Makerspace-Amiens-2025-26/MachineThatDraws-Groupe07/docs/images/pcb-components.jpg

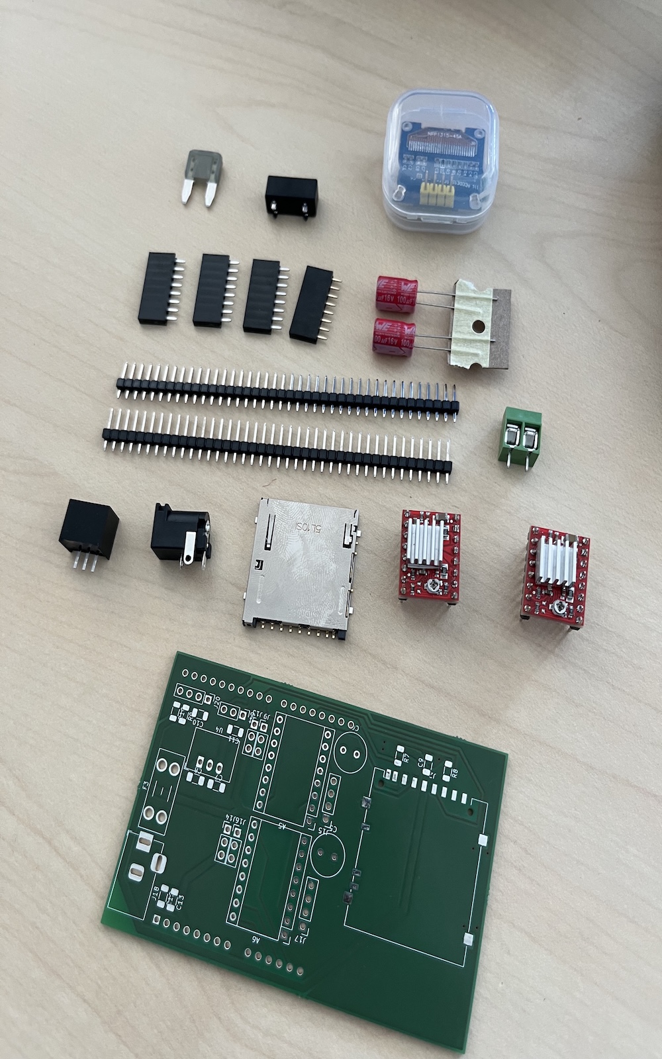
docs/images/pcb-components.jpg
