Makerspace-Amiens-2025-26/MachineThatDraws-Groupe07/docs/images/pcb-soldering.jpeg

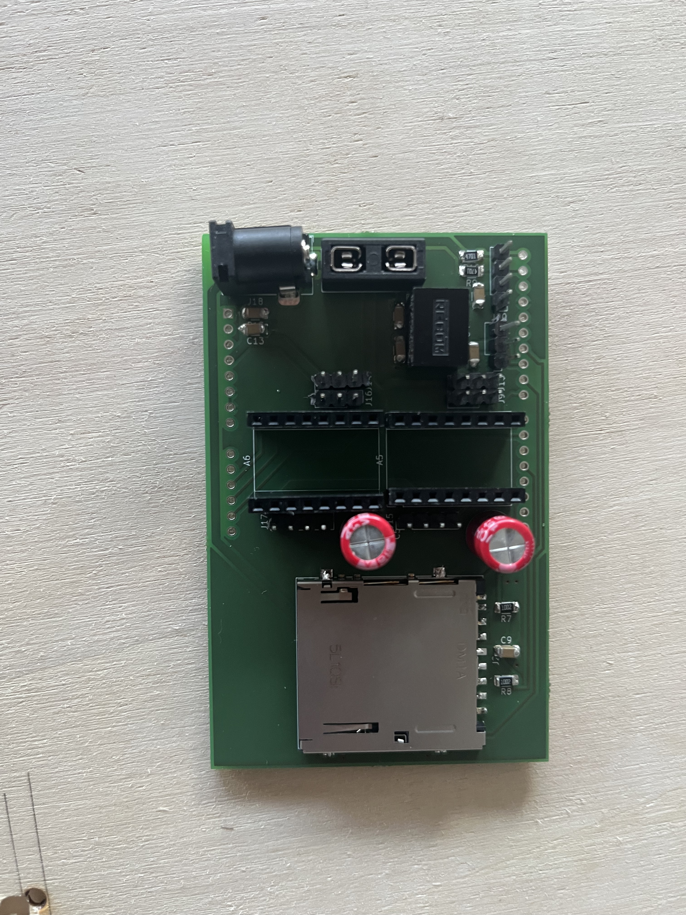
docs/images/pcb-soldering.jpeg
