Makerspace-Amiens-2025-26/MachineThatDraws-Groupe07/docs/index.md

Site
---
layout: home
nav_order: 1
title: Accueil
permalink: /
---

# Bienvenue sur notre documentation

Bienvenue dans la documentation de notre machine à dessiner nommée **"DrawBot A4"**.

Ce site a pour objectif de présenter notre projet, d’expliquer son fonctionnement et de fournir les informations nécessaires pour comprendre, utiliser et reproduire la machine.

Vous trouverez ci-dessous les principales ressources liées au projet, notamment les modèles 3D et le code source.

[Notre projet sur Onshape](https://cad.onshape.com/documents/e069393fab7baea4fdb59362/w/8d933c0b93562b63a8485ec1/e/e6b6ce24fbb03acfda1a5889){: .btn .btn-primary .fs-5 .mb-4 .mb-md-0 .mr-2 }
[Notre dépôt GitHub](https://github.com/Makerspace-Amiens/2026-MachineThatDraws-Groupe07/){: .btn .fs-5 .mb-4 .mb-md-0 }

{: .note }
> Le modèle 3D et la vidéo de présentation seront mis à jour au fur et à mesure de l’avancement du projet.

<iframe
height="600"
width="100%"
src="https://modelembedder.net/embed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"
frameborder="0">
</iframe>

## À propos du projet

Le **DrawBot A4** est une machine à dessiner utilisant un bras articulé.  
Ce projet nous permet d’apprendre et d’expérimenter la conception et la réalisation d’une machine répondant à un besoin concret : dessiner sur une feuille **A4**.

La machine peut également fonctionner comme un **traceur 2D**, capable de reproduire des images ou du texte de manière relativement précise.

## Poster du projet

Poster du projet DrawBot A4

## Vidéo de présentation

<video controls width="100%">
<source src="images/video_drawbot_a4.mp4" type="video/mp4">
</video>
