Makerspace-Amiens-2025-26/MachineThatDraws-Groupe07/docs/images/atelier.jpg

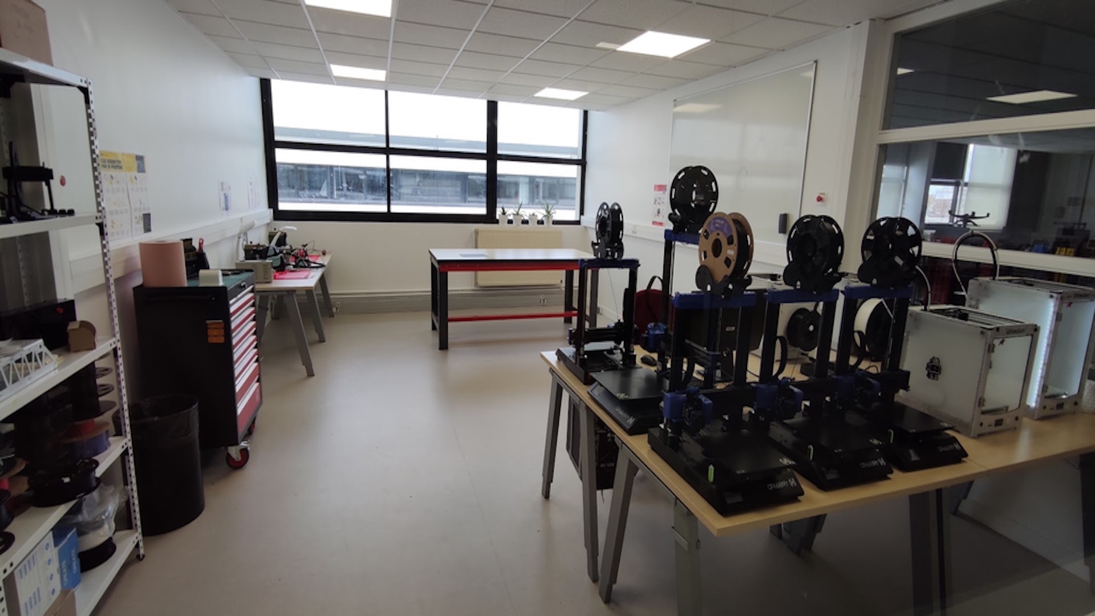
docs/images/atelier.jpg
