Makerspace-Amiens-2025-26/MachineThatDraws-Groupe07/docs/images/courroie.png

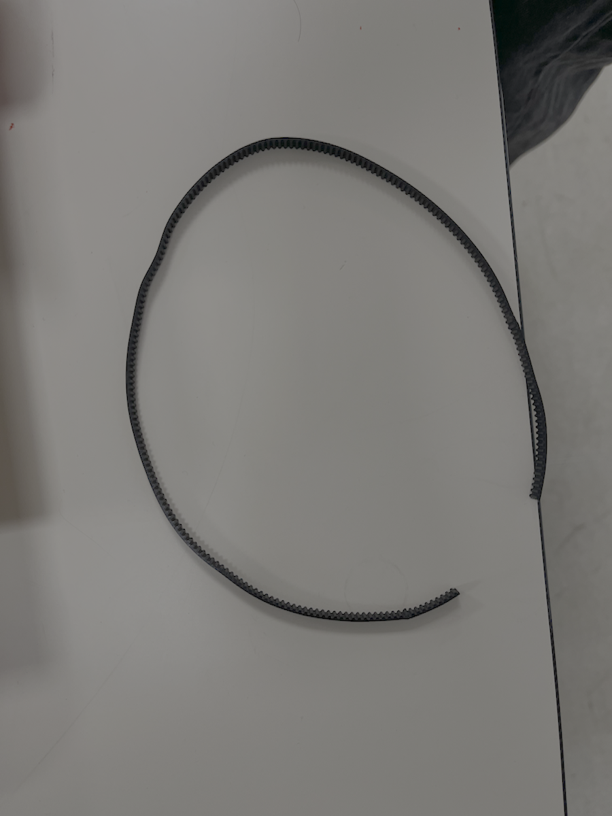
docs/images/courroie.png
