Makerspace-Amiens-2025-26/MachineThatDraws-Groupe07/docs/images/damien.jpg

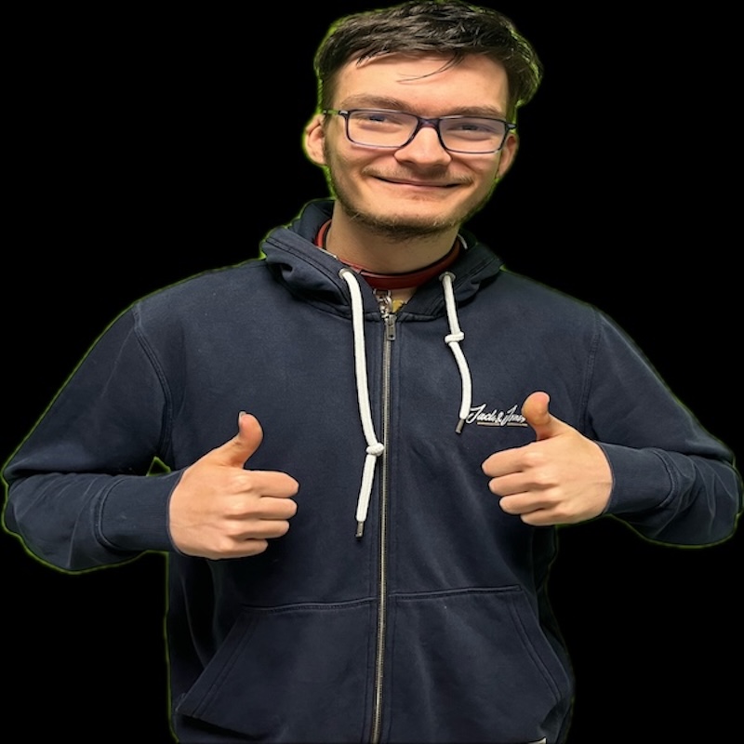
docs/images/damien.jpg
