Makerspace-Amiens-2025-26/MachineThatDraws-Groupe07/docs/images/feuille-support.png

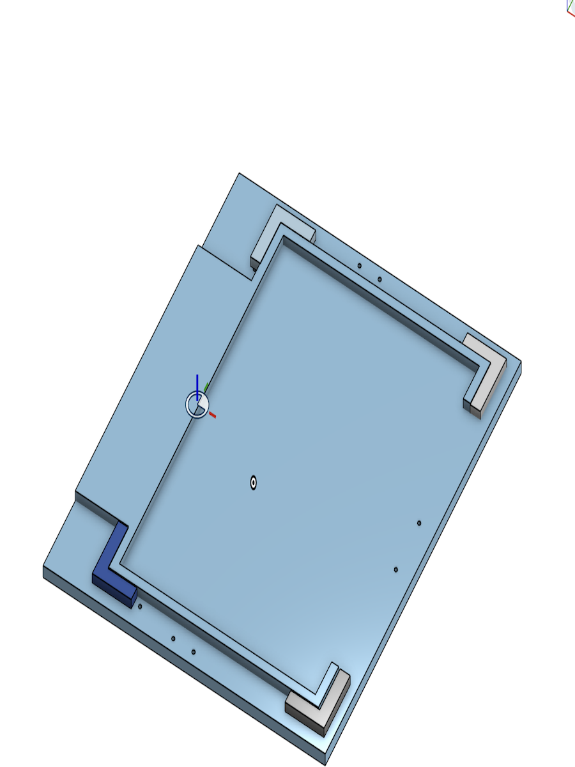
docs/images/feuille-support.png
