Makerspace-Amiens-2025-26/MachineThatDraws-Groupe07/docs/images/hero-drawbot.jpg

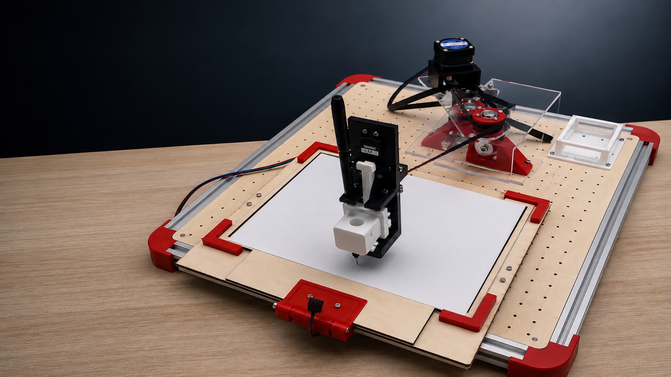
docs/images/hero-drawbot.jpg
