Makerspace-Amiens-2025-26/MachineThatDraws-Groupe07/docs/images/machine.png

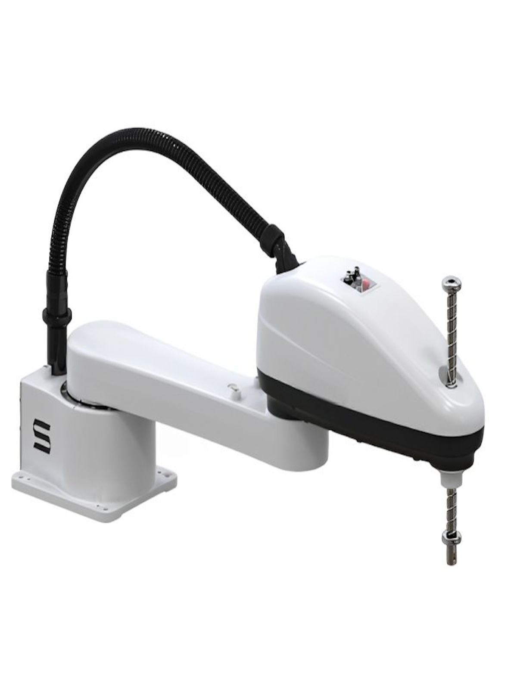
docs/images/machine.png
