Makerspace-Amiens-2025-26/MachineThatDraws-Groupe07/docs/images/maxence.jpg

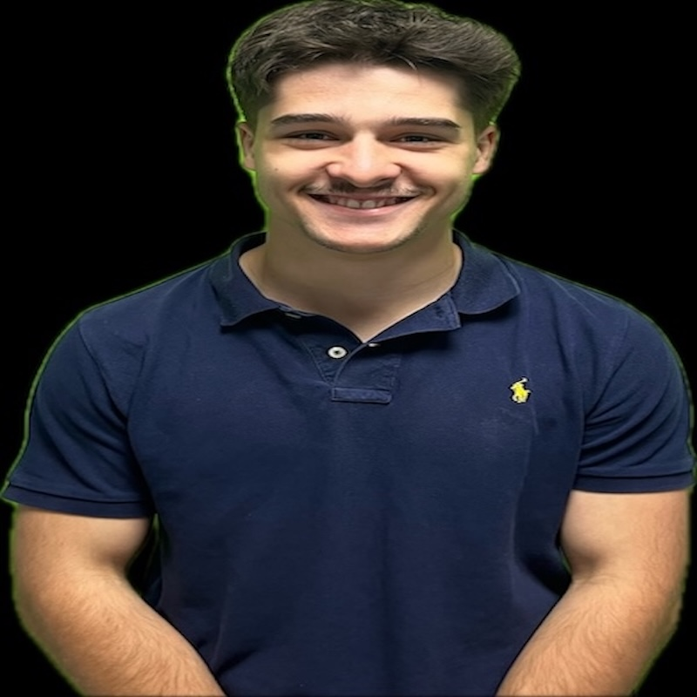
docs/images/maxence.jpg
