Makerspace-Amiens-2025-26/MachineThatDraws-Groupe07/docs/images/nadhem.jpg

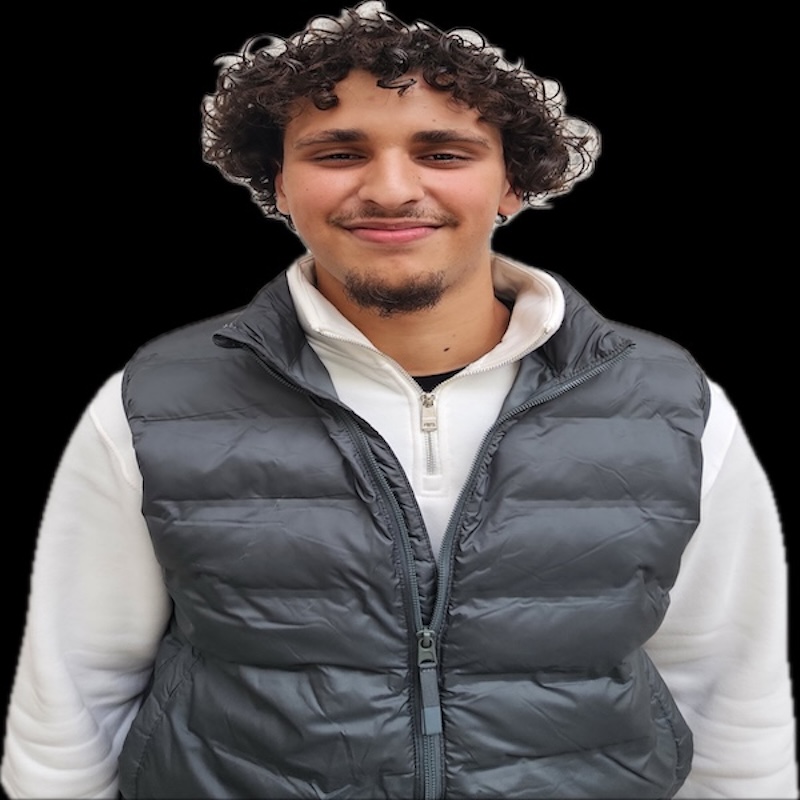
docs/images/nadhem.jpg
