Makerspace-Amiens-2025-26/MachineThatDraws-Groupe07/docs/images/onshape-arm.png

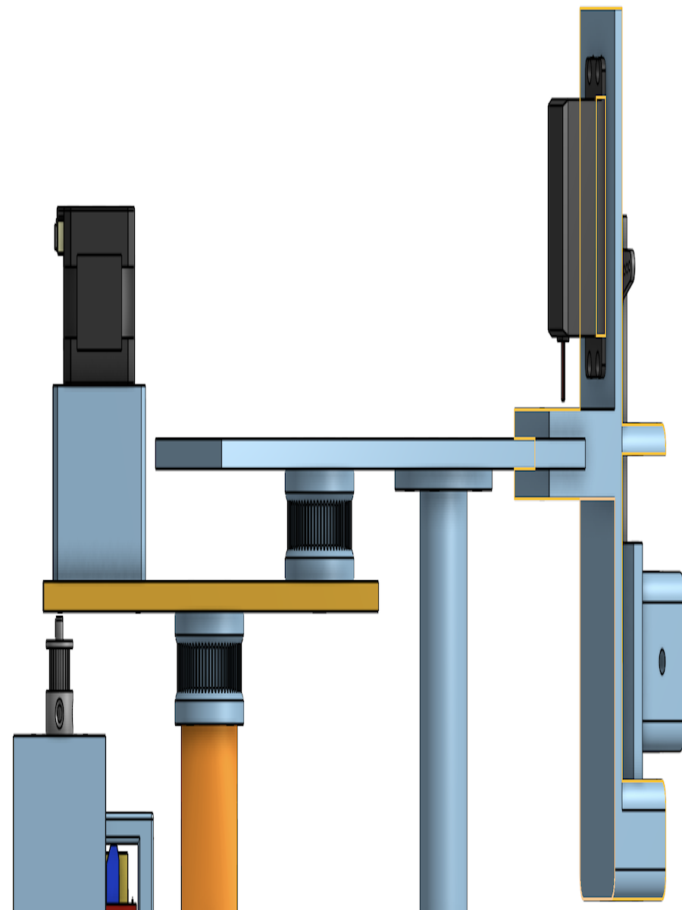
docs/images/onshape-arm.png
