Makerspace-Amiens-2025-26/MachineThatDraws-Groupe07/docs/images/pcb-final.jpg

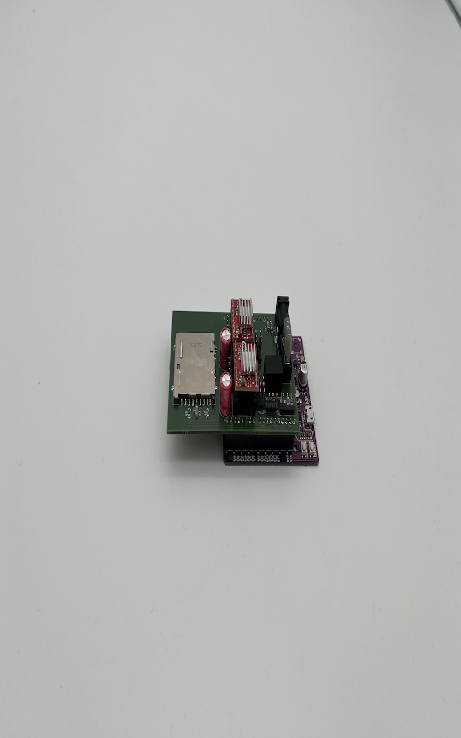
docs/images/pcb-final.jpg
