Makerspace-Amiens-2025-26/MachineThatDraws-Groupe07/docs/images/pcb.png

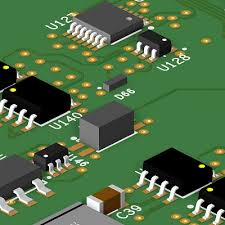
docs/images/pcb.png
