Makerspace-Amiens-2025-26/MachineThatDraws-Groupe07/docs/images/pcb_schema.png

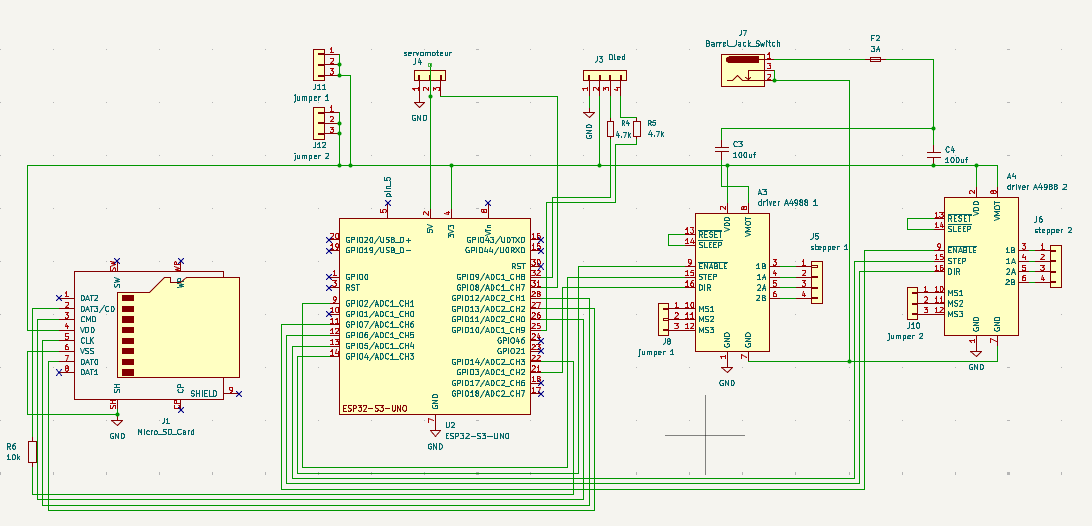
docs/images/pcb_schema.png
