Makerspace-Amiens-2025-26/MachineThatDraws-Groupe07/docs/images/poster-DrawBot.png

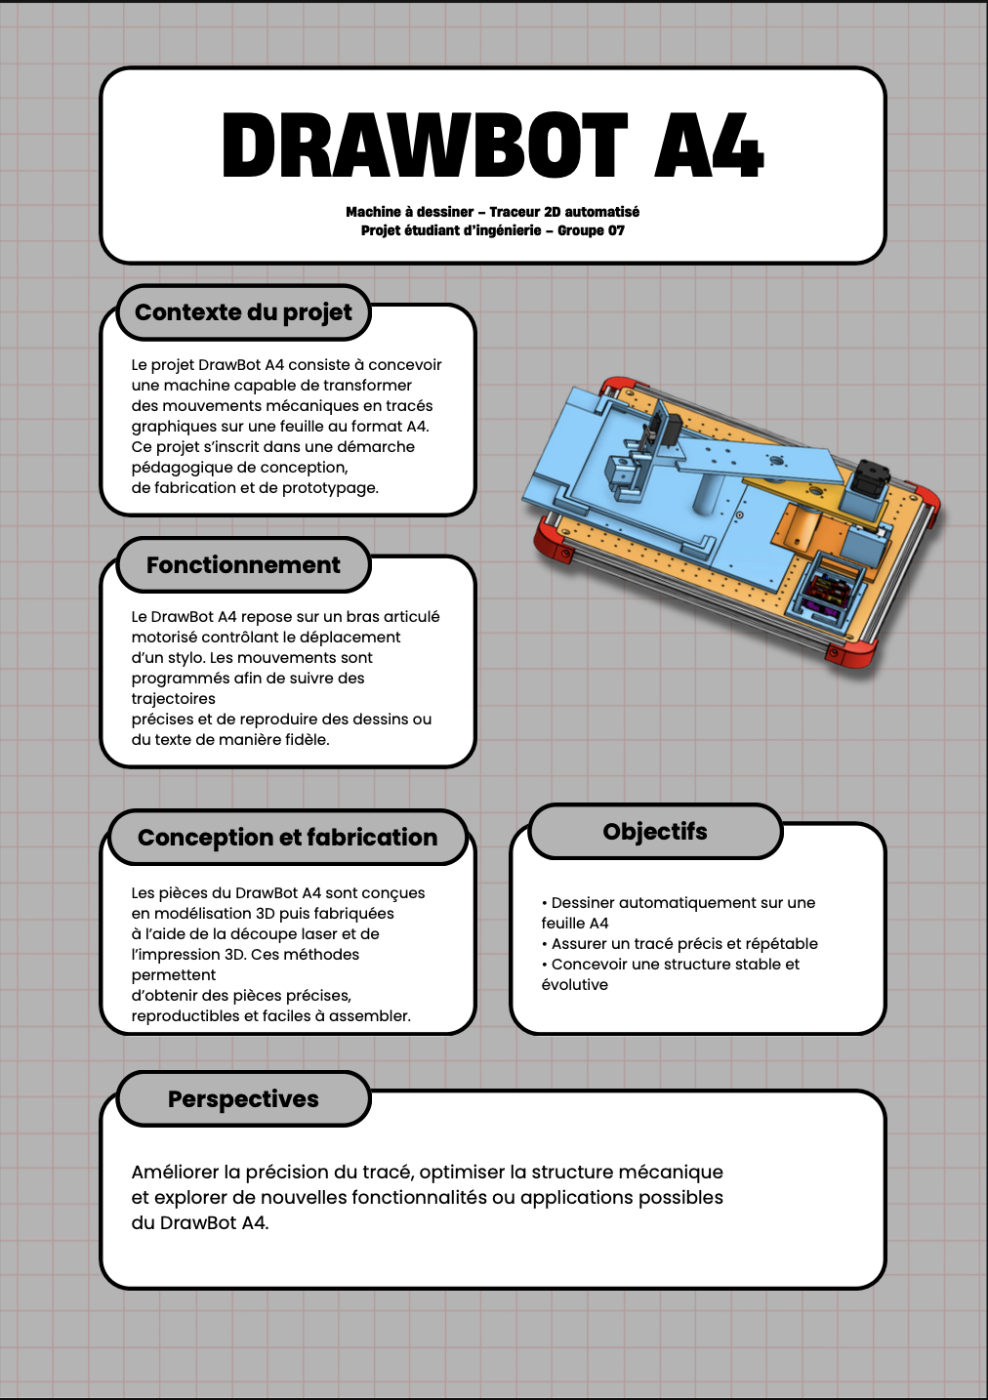
docs/images/poster-DrawBot.png
