Makerspace-Amiens-2025-26/MachineThatDraws-Groupe07/docs/images/pulley-system.png

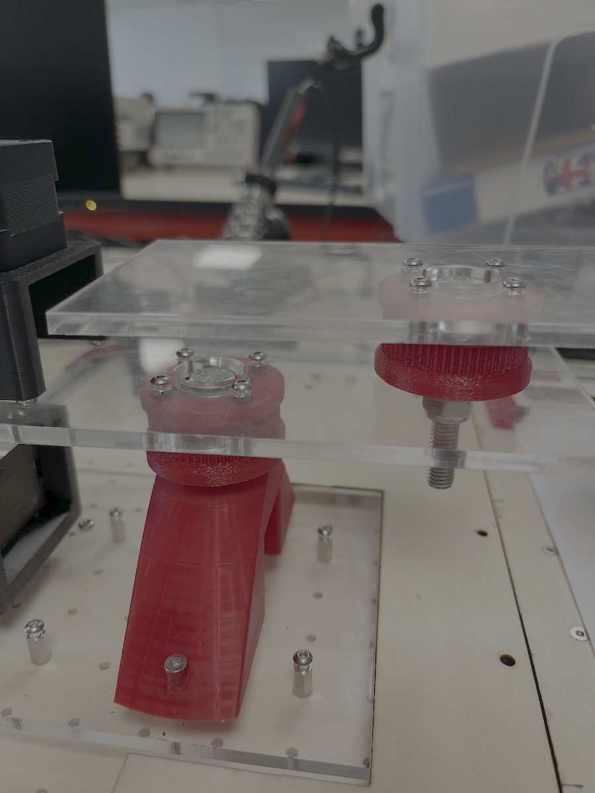
docs/images/pulley-system.png
