Makerspace-Amiens-2025-26/MachineThatDraws-Groupe07/docs/images/samantha.jpg

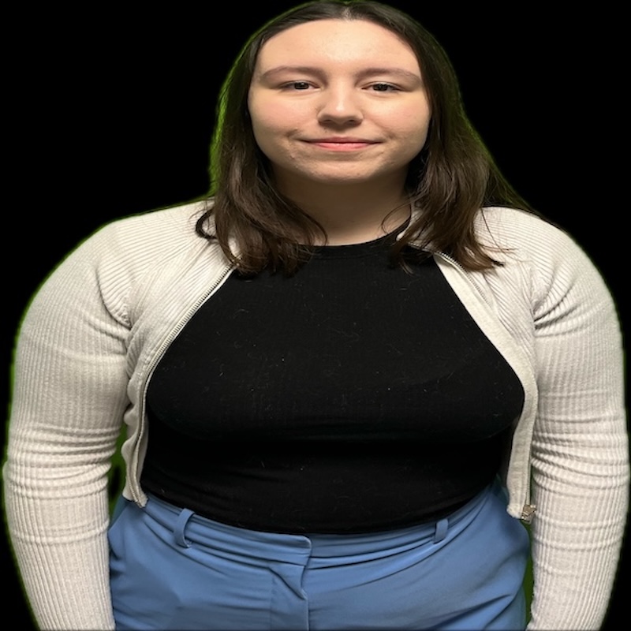
docs/images/samantha.jpg
