Makerspace-Amiens-2025-26/MachineThatDraws-Groupe07/docs/images/schema-electronique.png

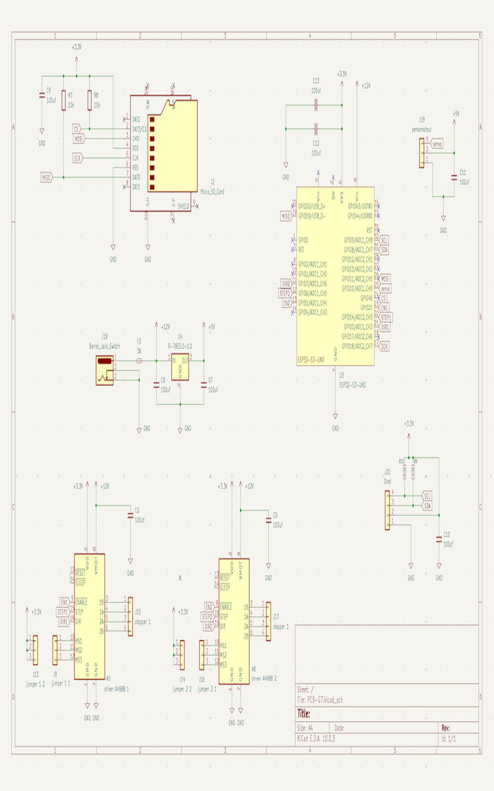
docs/images/schema-electronique.png
