Makerspace-Amiens-2025-26/MachineThatDraws-Groupe07/docs/images/schema-global.png

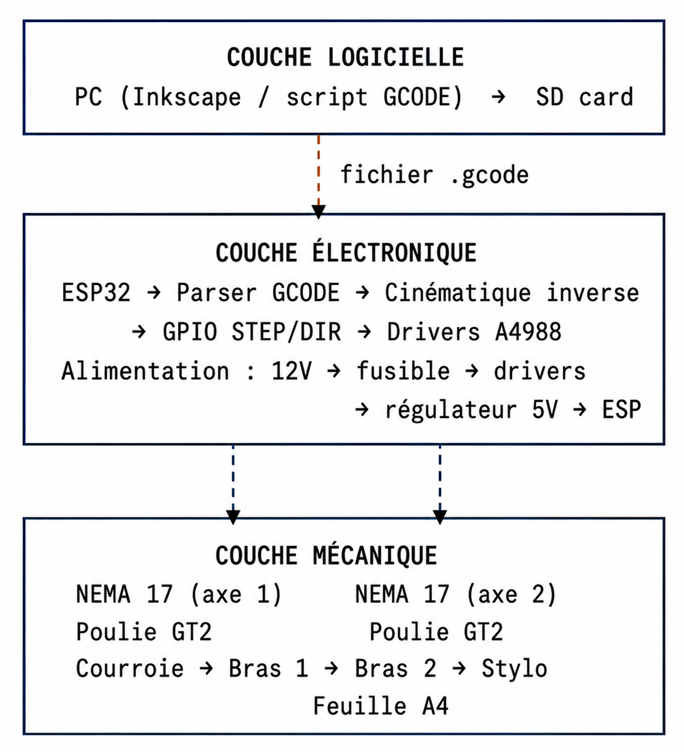
docs/images/schema-global.png
