Makerspace-Amiens-2025-26/MachineThatDraws-Groupe07/docs/images/schema_pcb.png

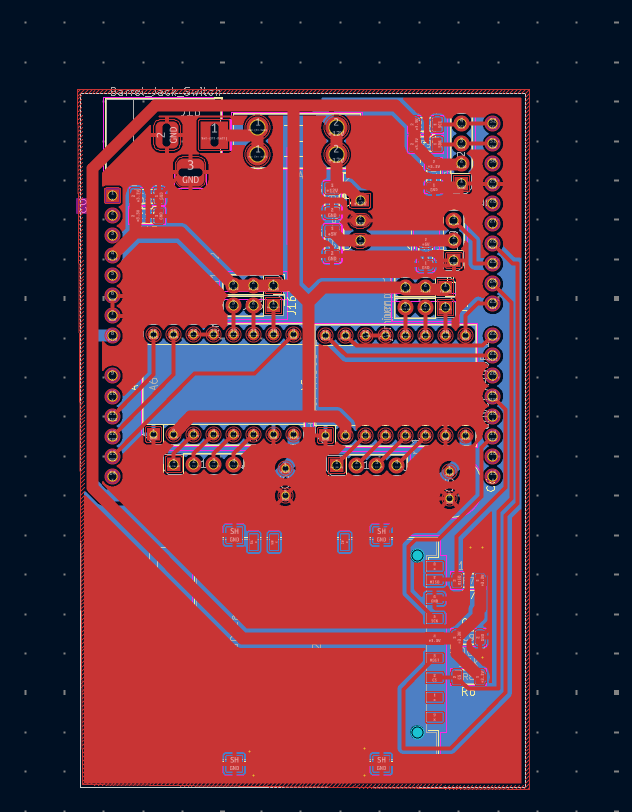
docs/images/schema_pcb.png
