Makerspace-Amiens-2025-26/MachineThatDraws-Groupe07/docs/images/support-moteur.png

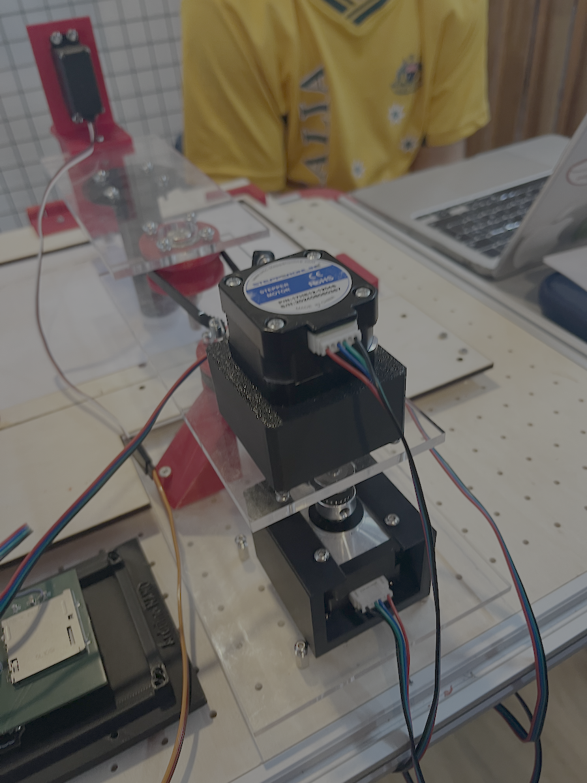
docs/images/support-moteur.png
