Makerspace-Amiens-2025-26/MachineThatDraws-Groupe07/docs/images/support-stylo.png

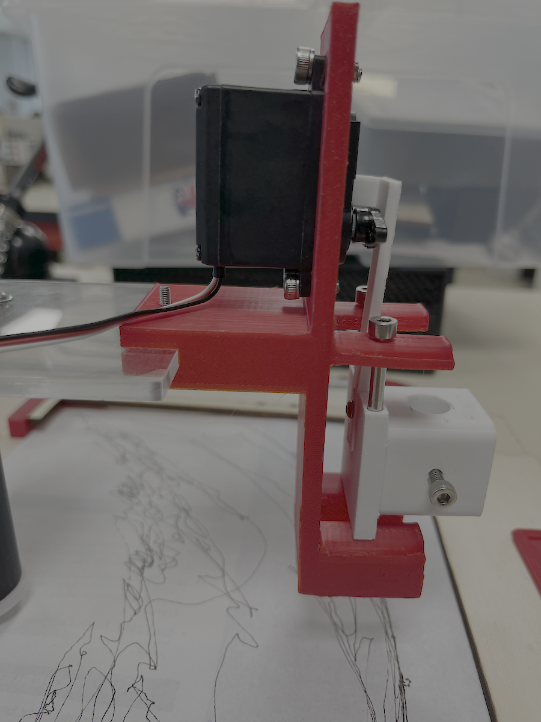
docs/images/support-stylo.png
