Makerspace-Amiens-2025-26/MachineThatDraws-Groupe07/docs/images/yasmine.jpg

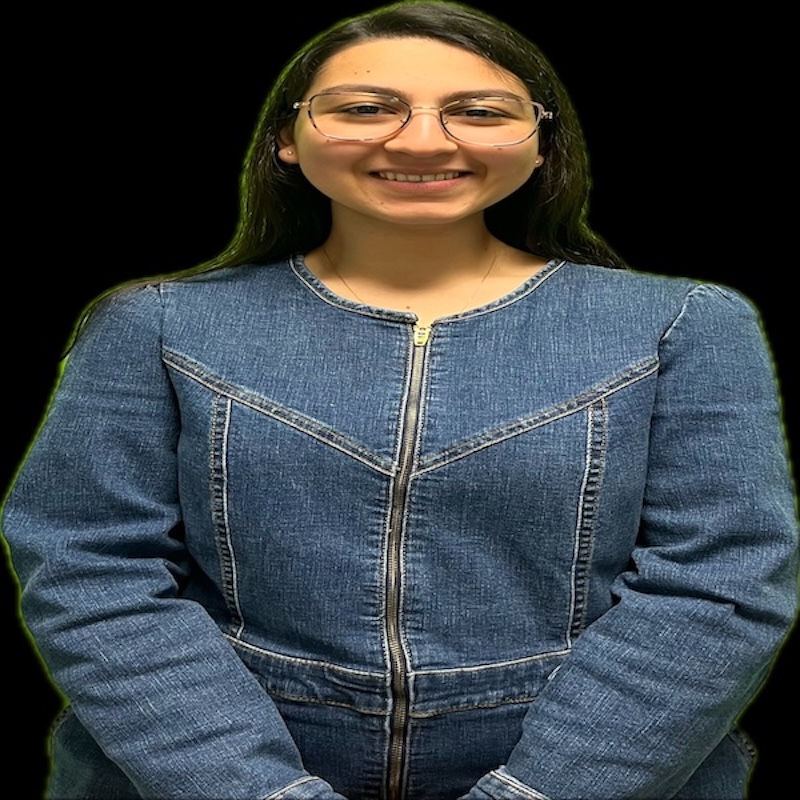
docs/images/yasmine.jpg
