Makerspace-Amiens-2025-26/MachineThatDraws-Groupe07/project/PCB G7/PCB-G7.kicad_pcb

## KiCad design project/PCB G7/PCB-G7.kicad_pcb (2026-04-27)

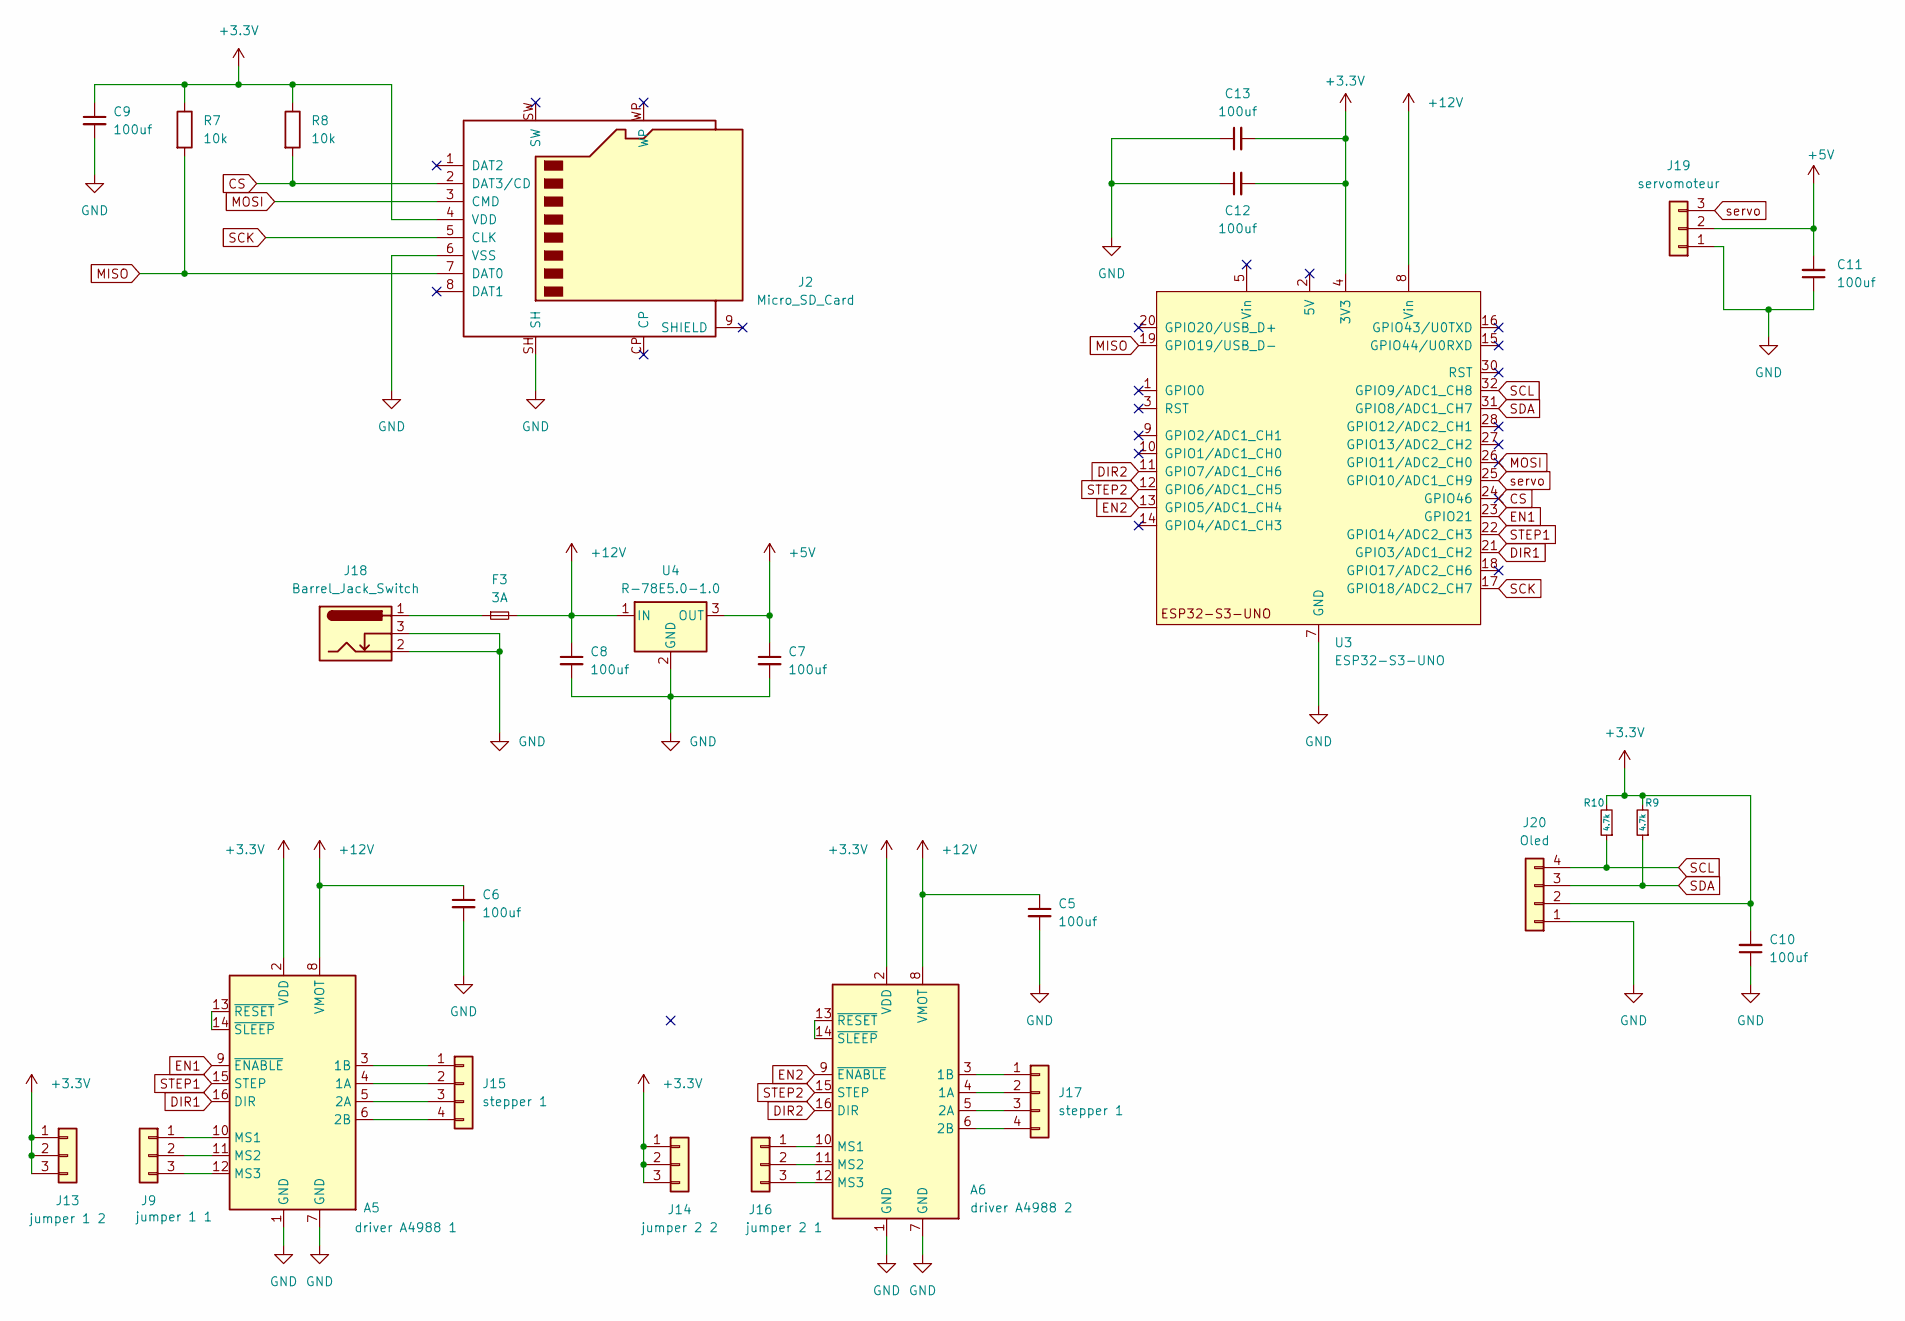
[picture p25: schematic PCB-G7.kicad_sch]

Parts:
A5: driver A4988 1; Pololu_Breakout-16_15.2x20.3mm
A6: driver A4988 2; Pololu_Breakout-16_15.2x20.3mm
C5, C6: 100uf; C_Radial_D8.0mm_H11.5mm_P3.50mm
C7, C8: 100uf; C_1206_3216Metric_Pad1.33x1.80mm_HandSolder
C9, C10, C12, C13: 100uf; C_1206
C11: 100uf; C_1206_3216Metric
F3: 3A; Fuseholder_Blade_Mini_Keystone_3568
J2: Micro_SD_Card; SD_Hirose_DM1AA_SF_PEJ82
J9: jumper 1 1; PinHeader_1x03_P2.54mm_Vertical
J13: jumper 1 2; PinHeader_1x03_P2.54mm_Vertical
J14: jumper 2 2; PinHeader_1x03_P2.54mm_Vertical
J15, J17: stepper 1; PinHeader_1x04_P2.54mm_Vertical
J16: jumper 2 1; PinHeader_1x03_P2.54mm_Vertical
J18: Barrel_Jack_Switch; BarrelJack_Horizontal
J19: servomoteur; PinHeader_1x03_P2.54mm_Vertical
J20: Oled; PinHeader_1x04_P2.54mm_Vertical
R7, R8: 10k; R_1206
R9, R10: 4.7k; R_1206
U3: ESP32-S3-UNO; ESP_S3_UNO
U4: R-78E5.0-1.0; Converter_DCDC_RECOM_R-78E-0.5_THT

Connections:
+3.3V: A5.2 (VDD), A6.2 (VDD), C9.1, C10.2, C12.2, C13.2, J2.4 (VDD), J13.1, J13.2, J13.3, J14.1, J14.2, J14.3, J20.2, R7.1, R8.1, R9.2, R10.2, U3.4 (3V3)
+5V: C7.1, C11.2, J19.2, U4.3 (OUT)
+12V: A5.8 (VMOT), A6.8 (VMOT), C5.1, C6.1, C8.1, F3.2, U3.8 (Vin), U4.1 (IN)
CS: J2.2 (DAT3/CD), R8.2, U3.24 (GPIO46)
DIR1: A5.16 (DIR), U3.21 (GPIO3/ADC1_CH2)
DIR2: A6.16 (DIR), U3.11 (GPIO7/ADC1_CH6)
EN1: A5.9 (~ENABLE), U3.23 (GPIO21)
EN2: A6.9 (~ENABLE), U3.13 (GPIO5/ADC1_CH4)
GND: A5.1 (GND), A5.7 (GND), A6.1 (GND), A6.7 (GND), C5.2, C6.2, C7.2, C8.2, C9.2, C10.1, C11.1, C12.1, C13.1, J2.6 (VSS), J2.SH, J18.2, J18.3, J19.1, J20.1, U3.6 (GND), U3.7 (GND), U3.29 (GND), U4.2 (GND)
MISO: J2.7 (DAT0), R7.2, U3.19 (GPIO19/USB_D-)
MOSI: J2.3 (CMD), U3.26 (GPIO11/ADC2_CH0)
unnamed: A5.4 (1A), J15.2
unnamed: A5.3 (1B), J15.1
unnamed: A5.5 (2A), J15.3
unnamed: A5.6 (2B), J15.4
unnamed: A5.10 (MS1), J9.1
unnamed: A5.11 (MS2), J9.2
unnamed: A5.12 (MS3), J9.3
unnamed: A5.13 (~RESET), A5.14 (~SLEEP)
unnamed: A6.4 (1A), J17.2
unnamed: A6.3 (1B), J17.1
unnamed: A6.5 (2A), J17.3
unnamed: A6.6 (2B), J17.4
unnamed: A6.10 (MS1), J16.1
unnamed: A6.11 (MS2), J16.2
unnamed: A6.12 (MS3), J16.3
unnamed: A6.13 (~RESET), A6.14 (~SLEEP)
unnamed: F3.1, J18.1
SCK: J2.5 (CLK), U3.17 (GPIO18/ADC2_CH7)
SCL: J20.4, R10.1, U3.32 (GPIO9/ADC1_CH8)
SDA: J20.3, R9.1, U3.31 (GPIO8/ADC1_CH7)
STEP1: A5.15 (STEP), U3.22 (GPIO14/ADC2_CH3)
STEP2: A6.15 (STEP), U3.12 (GPIO6/ADC1_CH5)
servo: J19.3, U3.25 (GPIO10/ADC1_CH9)

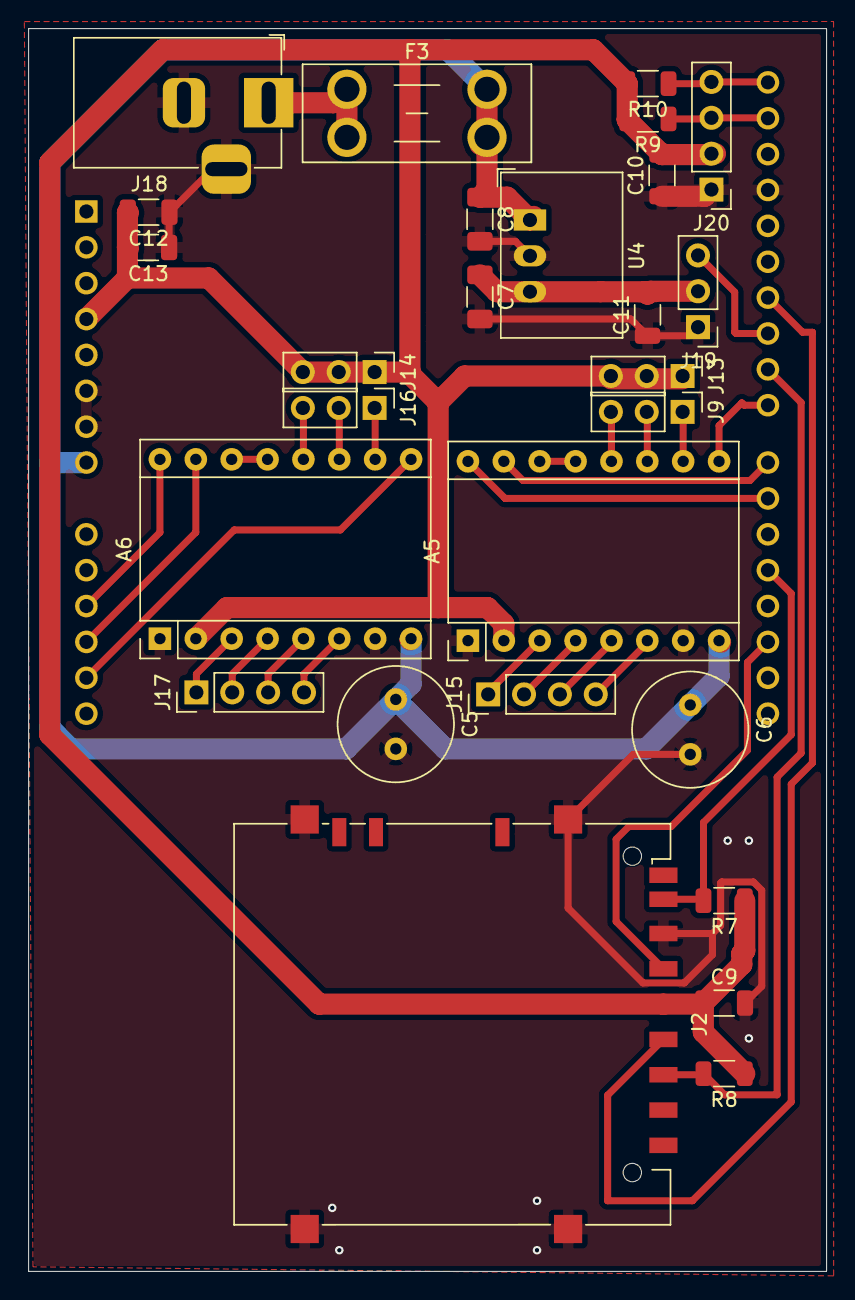
[picture p26: board PCB-G7.kicad_pcb from above]

Board: 2 copper layers, 56.5 x 88.0 mm, 28 parts (0 on the bottom side), 34 nets.
