Makerspace-Amiens-2025-26/MachineThatDraws-Groupe07/docs/images/makerspace.jpg

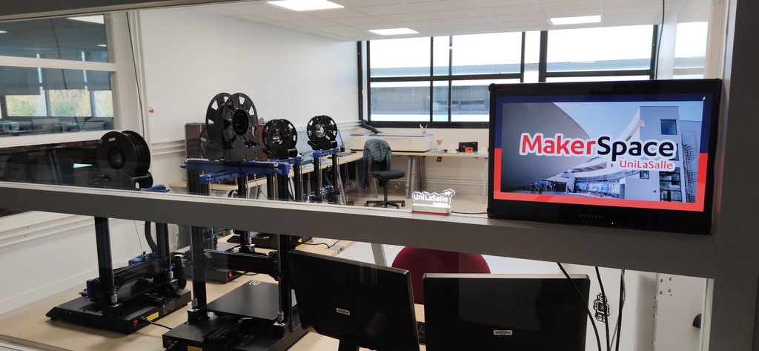
docs/images/makerspace.jpg
