Makerspace-Amiens-2025-26/MachineThatDraws-Groupe07/docs/images/onshape-assembly.png

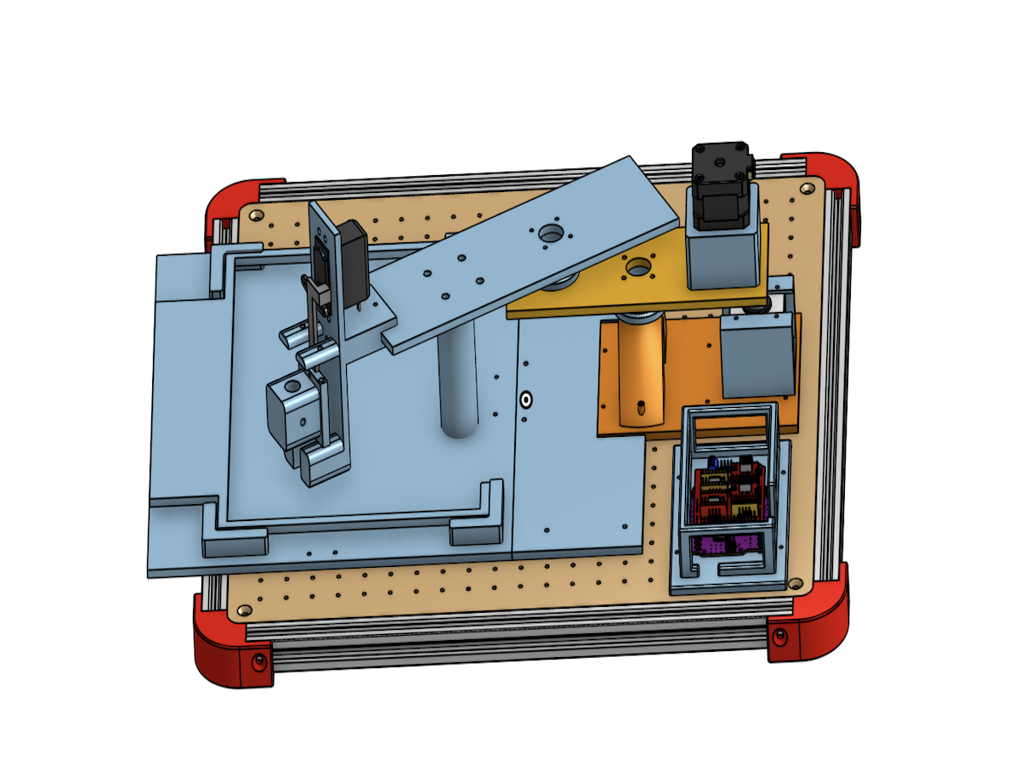
docs/images/onshape-assembly.png
