Makerspace-Amiens-2025-26/MachineThatDraws-Groupe07/docs/images/pcb-soldering.jpg

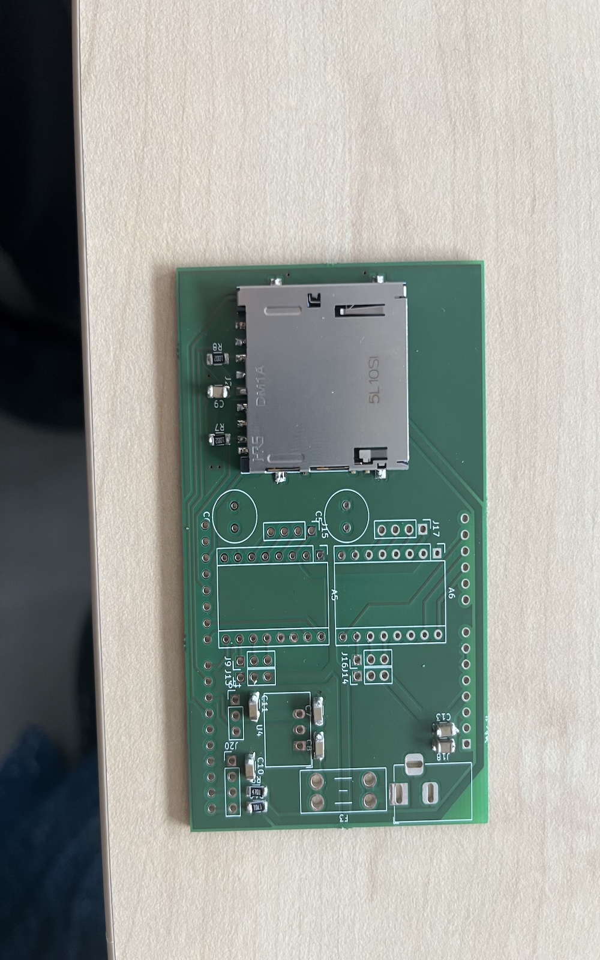
docs/images/pcb-soldering.jpg
