Makerspace-Amiens-2025-26/MachineThatDraws-Groupe07/(commit log)

2026-03-11 Add PCB project documentation
    Document the PCB project objectives and steps.
2026-03-11 Add landing page layout in landing.html
2026-03-11 Revise PCB project documentation and specifications
    Updated the PCB project documentation to reflect new design objectives, specifications, and project steps.
2026-03-11 Revise PCB documentation for DrawBot A4 project
    Updated the PCB design documentation to reflect changes in project scope and component specifications.
2026-03-11 Revise PCB documentation for clarity and structure
2026-03-25 remplacement PCB
    J'ai déplacer les fichiers de la pcb dans le dossier projet, j'ai pu y apporter notament des modifications répondant aux demandes concernant le schematics , si je ne me trompe pas il manque un step down à placer et je pense que le reste de la carte semble correcte. si tout et bon je passerai alors au routage du pcb dès que possible
2026-03-25 update schematics
    mise à jour avec le schema actuel
2026-04-10 update schematics et pcb
    [PCB-G7.kicad_pcb, PCB-G7.kicad_sch]
2026-04-22 update pcb
    [PCB-G7.kicad_pcb, PCB-G7.kicad_sch]
2026-04-24 Validation PCB pour production
    Attention :
    - Plan de masse sur les deux couches
    [PCB-G7.kicad_pcb]
2026-04-27 fix some wiring problems
    [PCB-G7.kicad_pcb, PCB-G7.kicad_sch]
2026-06-06 Revamp documentation for DrawBot A4 project
    The documentation has been significantly expanded to include detailed sections on the DrawBot A4 project, including its mechanical, electronic, and software components, as well as assembly instructions and a complete engineering folder structure.
2026-06-08 Replace pulley image with DrawBot poster image
